misha-dig/TWINKLING_CHRISTMAS_LIGHT/Electronics design/README.md

# Folder for electronics design

This folder is situable for storage electronics designs and materials

In this folder is included:
1) Schematic
2) PCB designing
3) Bill of material of electronics components
4) Datasheets of electronics components

Note: Each version of sechmatics and PCB will added subfolder
