misha-dig/TWINKLING_CHRISTMAS_LIGHT/Electronics design/Schematic and PCB version 1.0/EASYEDA FILE/README.MD

# About EASYEDA files

This json file for opening sechmatics and PCB via EASYEDA Website software, you can modify and customise PCB and sechmatics for personal usage.

You must notice copyright about my PCB and sechmatic. You can look my license in folder 'TWINKLING_CHRISTMAS_LIGHT' 

Copyright (C) Misha Zaslavskis

## How to open this file ## 

1. You need to select 'File' -> 'Open' -> 'EasyEDA' EasyEda menu bar, which part of screenshoot is showed. 



2. Select a single downloaded EasyEDA json file and click a button 'Open' in file select window.



3. Select 'import file' in file operation and click 'Import' button in 'Open EasyEDA file' window. 
 


4. You opened the file amd started to edit your PCB and sechmatics for this project!!! 
