misha-dig/TWINKLING_CHRISTMAS_LIGHT/Electronics design/Schematic and PCB version 1.0/Schematic_TWINKLING_CHRISMATIS_LIGHT_2023-04-17.pdf

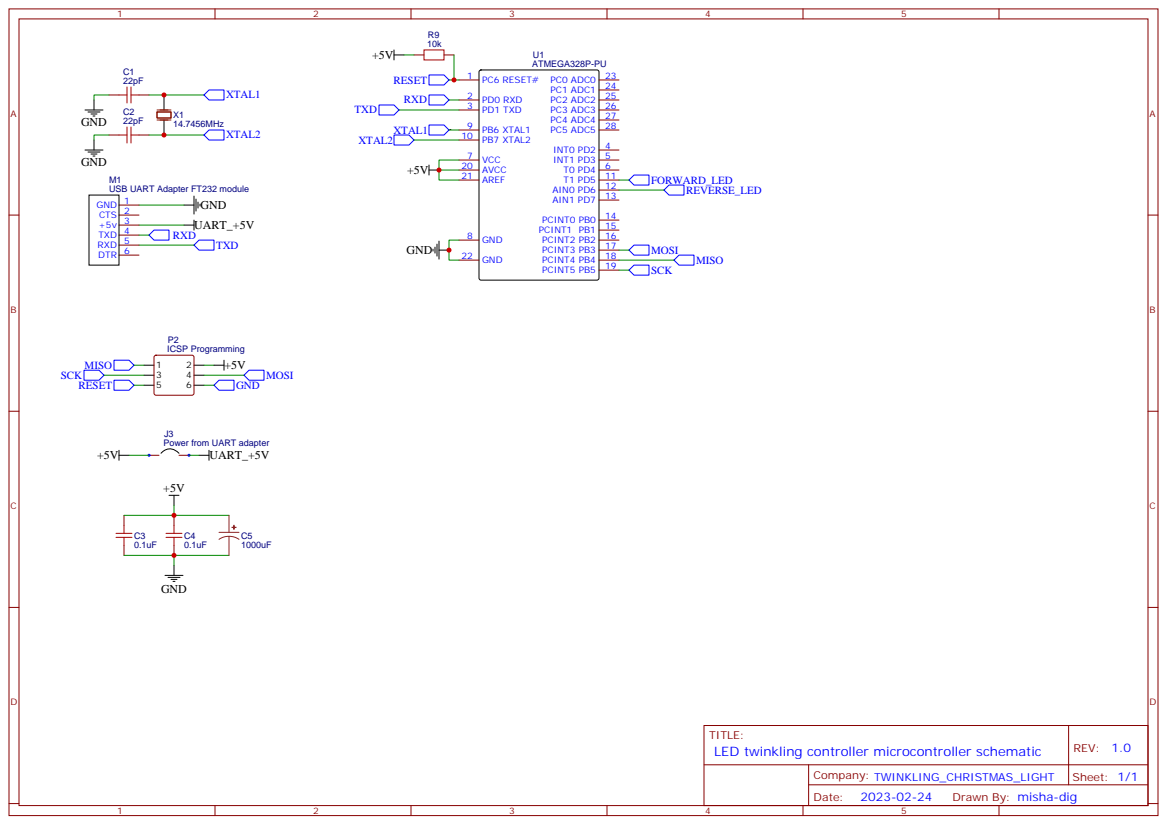
[picture p1: page 1]

Power from UART adapter

Drawn By: misha-dig

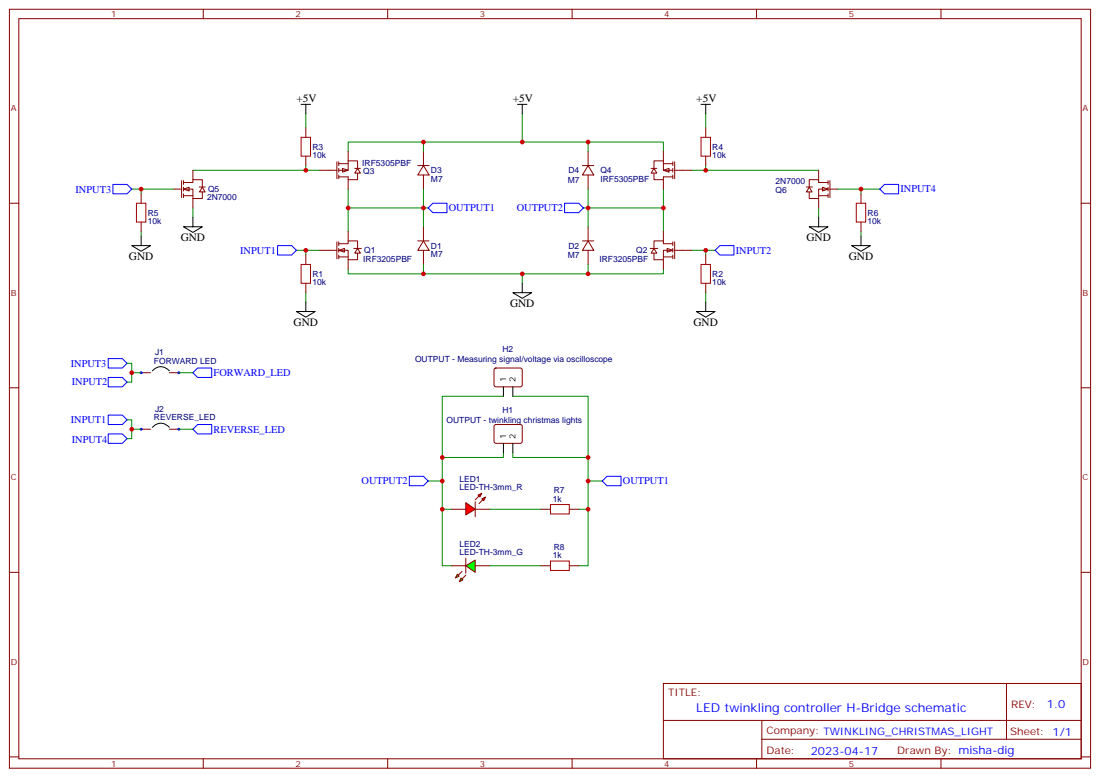
[picture p2: page 2]

OUTPUT - Measuring signal/voltage via oscilloscope

OUTPUT - twinkling christmas lights

Drawn By: misha-dig
