misha-dig/TWINKLING_CHRISTMAS_LIGHT/(list of files, drawings)

Other design files:
Electronics design/Schematic and PCB version 1.0/EASYEDA FILE/PCB_TWINKLING_CHRISMATIS_LIGHT_2023-04-27.json
Electronics design/Schematic and PCB version 1.0/EASYEDA FILE/SCH_TWINKLING_CHRISMATIS_LIGHT_2023-04-27.json
