misha-dig/TWINKLING_CHRISTMAS_LIGHT/(commit log)

2023-04-17 Add files via upload
    Added Gerber file for PCB and PDF file for schematic
2023-04-27 Add files via upload
    Added important electronics components in BOM material list table for this version PCB and schematics.
    [BOM_PCB_TWINKLING_CHRISMATIS_LIGHT_2023-04-18.csv]
2023-04-27 Create README.MD
    Added instruction how to open EasyEDA file for modifying PCB and schematic
2023-04-27 Add files via upload
    Added EasyEDA files
    - One file for schematic
    - One file for PCB layout
    [PCB_TWINKLING_CHRISMATIS_LIGHT_2023-04-27.json, SCH_TWINKLING_CHRISMATIS_LIGHT_2023-04-27.json]
